Kamiwng1992/XUAN-Bike/3.Software/Unity/ROSBridgeClient/Assets/Packages/InControl/Examples/TouchControls/Sprites/TouchButton_Y.png

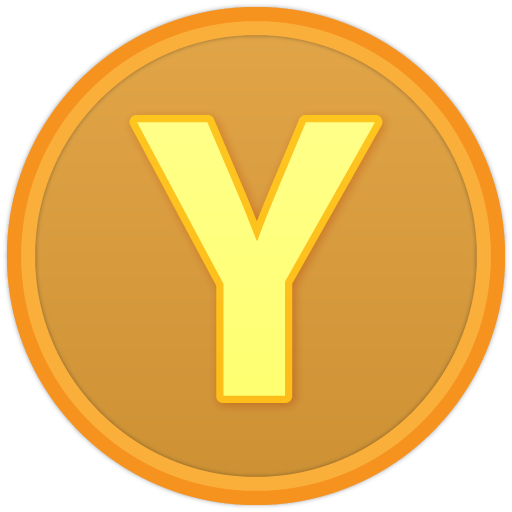
3.Software/Unity/ROSBridgeClient/Assets/Packages/InControl/Examples/TouchControls/Sprites/TouchButton_Y.png
