Kamiwng1992/XUAN-Bike/3.Software/Unity/ROSBridgeClient/Assets/Packages/InControl/Examples/TouchControls/Sprites/TouchStick_Knob.png

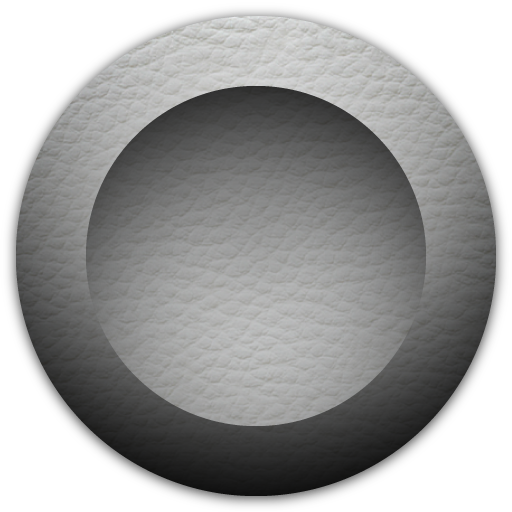
3.Software/Unity/ROSBridgeClient/Assets/Packages/InControl/Examples/TouchControls/Sprites/TouchStick_Knob.png
