Kamiwng1992/XUAN-Bike/4.Mechanic/XUAN加工件/动量驱动定子/攻丝.jpg

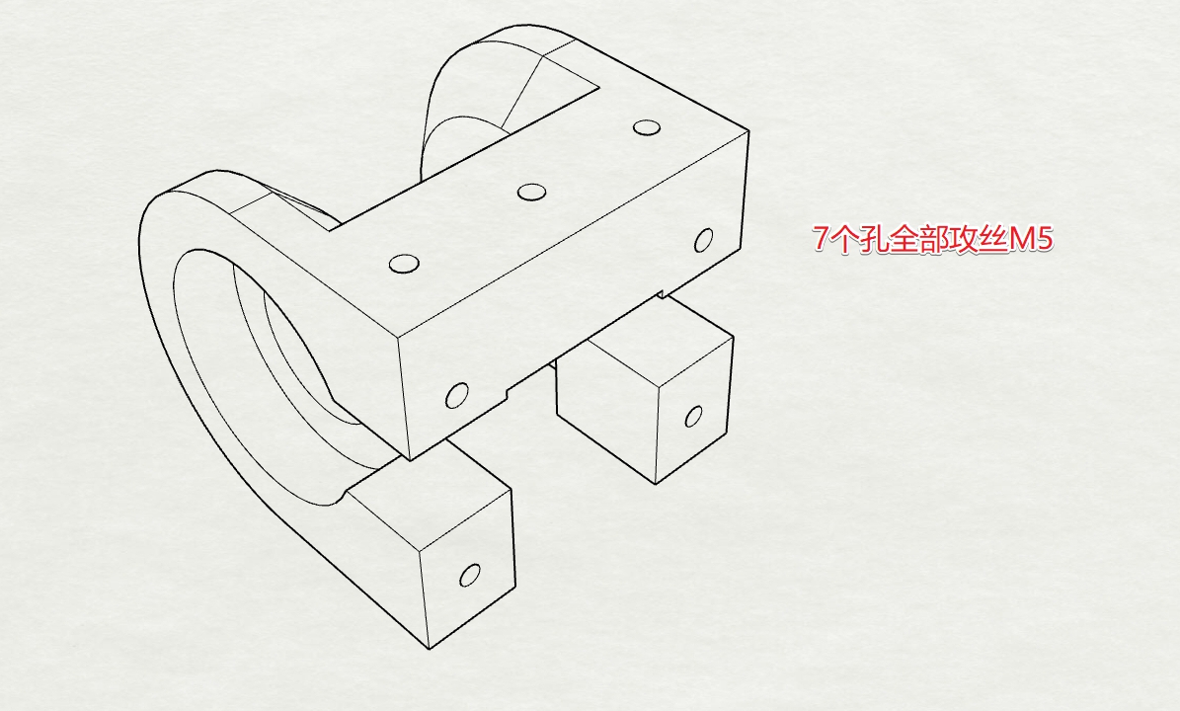
4.Mechanic/XUAN加工件/动量驱动定子/攻丝.jpg
