Kamiwng1992/XUAN-Bike/4.Mechanic/XUAN加工件/后轮驱动定子/1.jpg

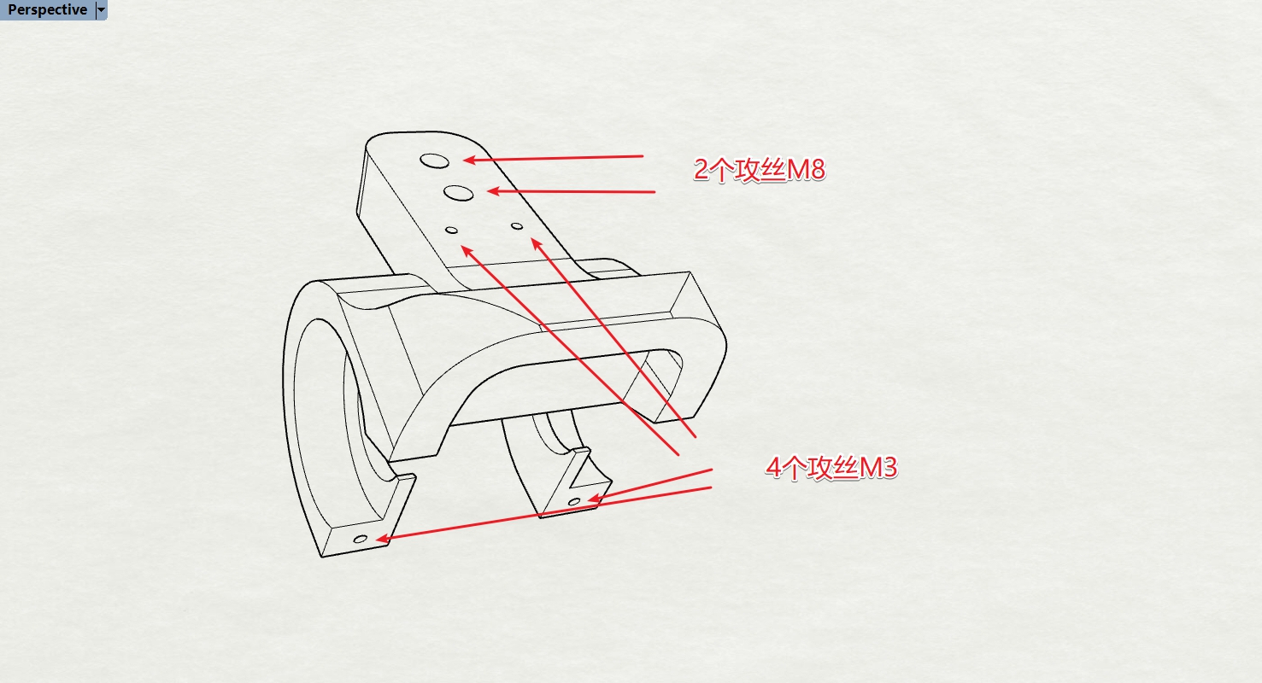
4.Mechanic/XUAN加工件/后轮驱动定子/1.jpg
