Kamiwng1992/XUAN-Bike/4.Mechanic/XUAN加工件/后轮驱动定子/2.jpg

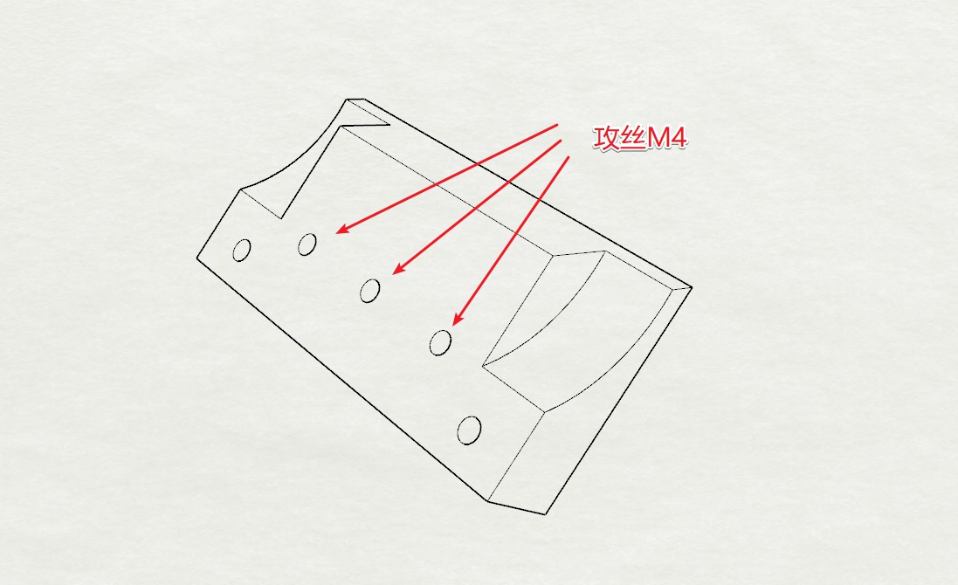
4.Mechanic/XUAN加工件/后轮驱动定子/2.jpg
