Kamiwng1992/XUAN-Bike/4.Mechanic/XUAN加工件/舵机支架/1.jpg

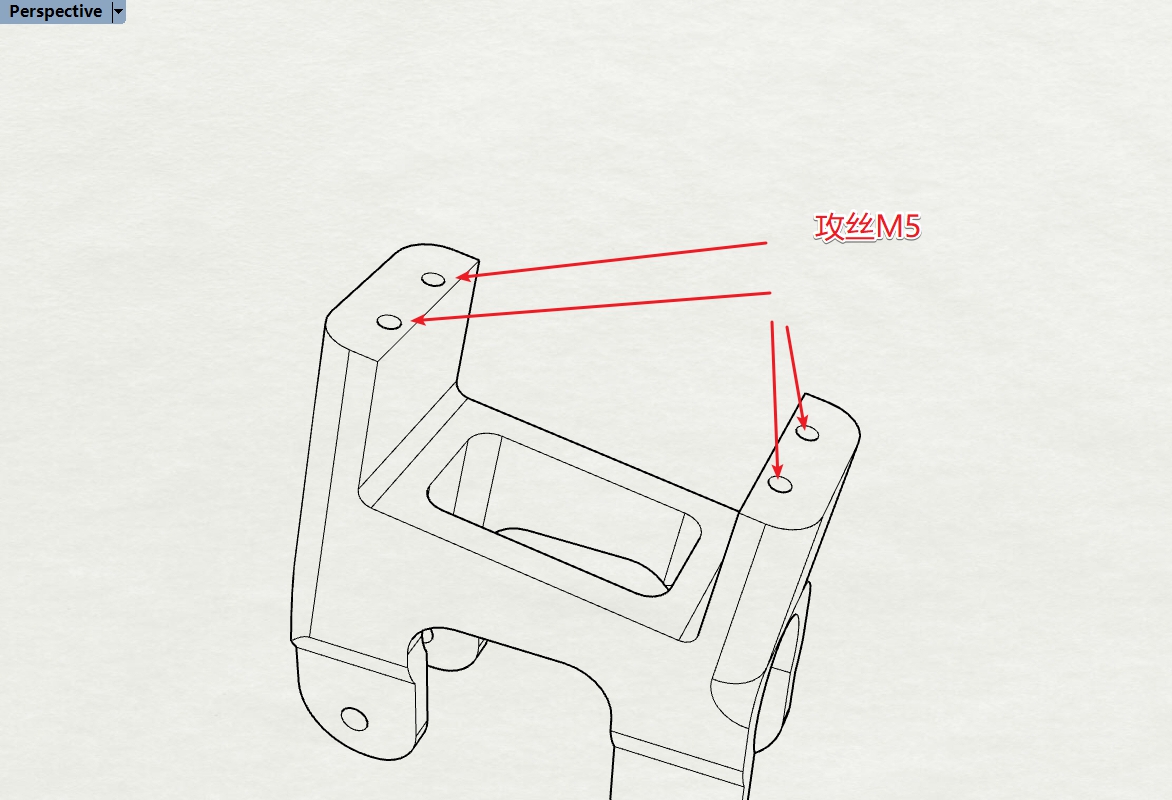
4.Mechanic/XUAN加工件/舵机支架/1.jpg
