Kamiwng1992/XUAN-Bike/(list of files, cad)

Other CAD files:
4.Mechanic/XUAN加工件/动量驱动动子/动量驱动动子.3dm
4.Mechanic/XUAN加工件/动量驱动定子/动量驱动定子.3dm
4.Mechanic/XUAN加工件/后轮驱动动子/后轮驱动动子.3dm
4.Mechanic/XUAN加工件/后轮驱动定子/后轮驱动定子1.3dm
4.Mechanic/XUAN加工件/后轮驱动定子/后轮驱动定子2.3dm
4.Mechanic/XUAN加工件/舵机支架/舵机支架.3dm
