Kamiwng1992/XUAN-Bike/(list of files, drawings)

Other design files:
1.Hardware/ControlUnit/ControlUnit.PrjPCB
1.Hardware/ControlUnit/Main.SchDoc
