Kamiwng1992/XUAN-Bike/3.Software/ROS/RPi/xuan_ros_sample/src/unity_ros_bridge/scripts/data_subscriber.py

#!/usr/bin/env python3
#coding=utf-8

import rospy
from unity_ros_bridge.msg import Xuan
import serial
import time

ser = serial.Serial("/dev/ttyS0", 115200)

def callback(data):
    # rospy.loginfo(rospy.get_caller_id() + 'I heard %s', data.servo_angle)
    print(data.servo_angle," ",data.speed)
    cmd = "move -a " + str(int(data.servo_angle)) + " -s " +  str(int(data.speed)) + "\n"
    ser.write(cmd.encode())

def listener():

    # In ROS, nodes are uniquely named. If two nodes with the same
    # name are launched, the previous one is kicked off. The
    # anonymous=True flag means that rospy will choose a unique
    # name for our 'listener' node so that multiple listeners can
    # run simultaneously.
    rospy.init_node('rpi_data_subscriber_py', anonymous=True)

    rospy.Subscriber('xuan_data', Xuan, callback)

    # spin() simply keeps python from exiting until this node is stopped
    rospy.spin()

if __name__ == '__main__':
    listener()
