Kamiwng1992/XUAN-Bike/(commit log)

2021-05-30 Reinit repo.
    [ControlUnit.PrjPCB, Main.SchDoc, 动量驱动动子.3dm, 动量驱动定子.3dm, 后轮驱动动子.3dm, 后轮驱动定子1.3dm, 后轮驱动定子2.3dm, 舵机支架.3dm]
2021-05-30 [Fw] Add OLED thread; already stable!
2021-06-02 [Fw] Add Servo support.
2021-06-02 [Fw] Remove output-N param & add servo CLI cmd.
2021-06-03 [Fw] Fix PID intergral BUG.
    [Robot.h, main.cpp]
2021-06-03 [Fw] Solve random unstable problem by increase ControlTask priority.
    [Robot.cpp, main.cpp]
2021-06-03 [Fw] Fix RPi serial pin bug.
    [main.cpp]
2021-06-07 [Hw] Remove servo interface.
    [ControlUnit.PrjPCB]
